vd141/Conductive-Fiber-Factory/Ink Parts/final Ink.SLDASM

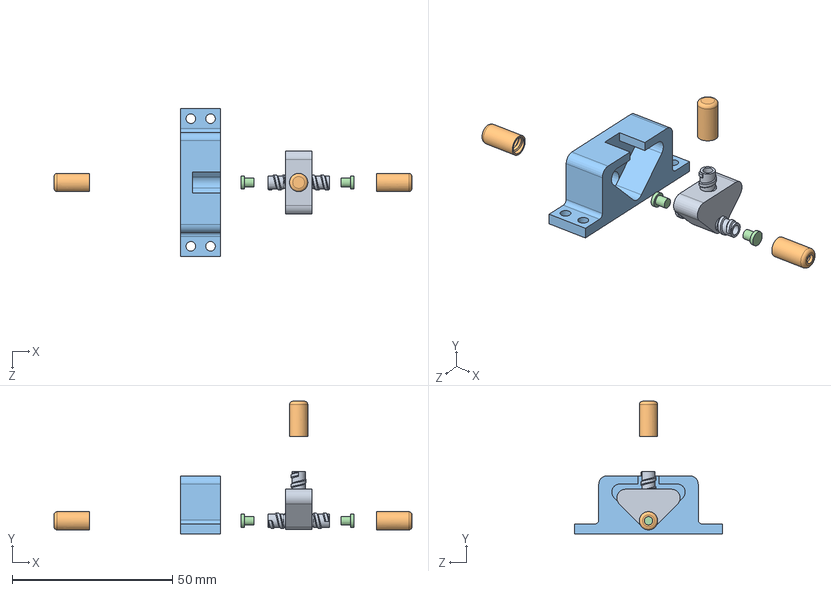
[picture p7: CAD file, 2020-08-11]
Ink Parts/final Ink.SLDASM
111.6 x 41.3 x 46.0 mm
finalCartridge
finalCap x 3
finalCartridgeHolder
PDMS Stopper x 2
