vd141/Conductive-Fiber-Factory/Ink Parts/inkAssembly.SLDASM

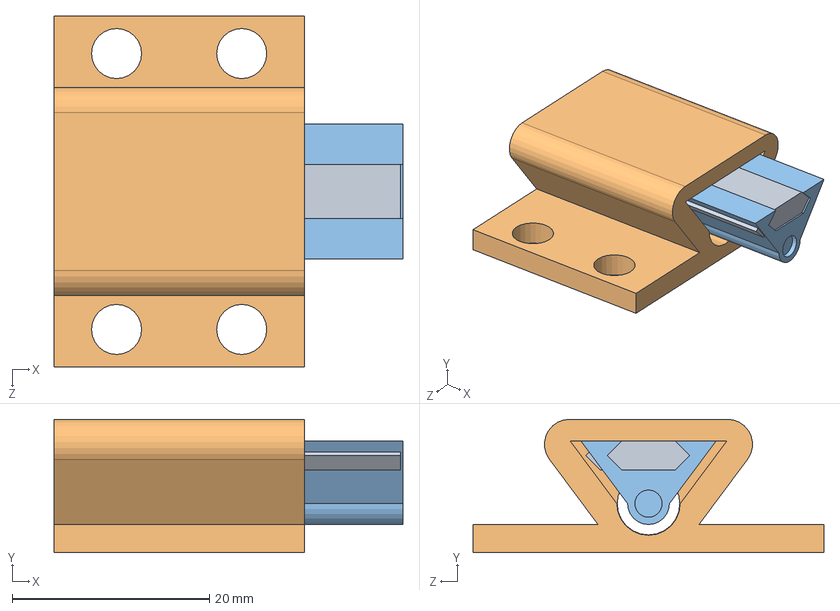
[picture p8: CAD file, 2020-08-11]
Ink Parts/inkAssembly.SLDASM
35.4 x 13.5 x 35.6 mm
newInkCartridgeLid
holdCartridge
newInkCartridge
