vd141/Conductive-Fiber-Factory/Ink Parts/homogenizer and ink.SLDASM

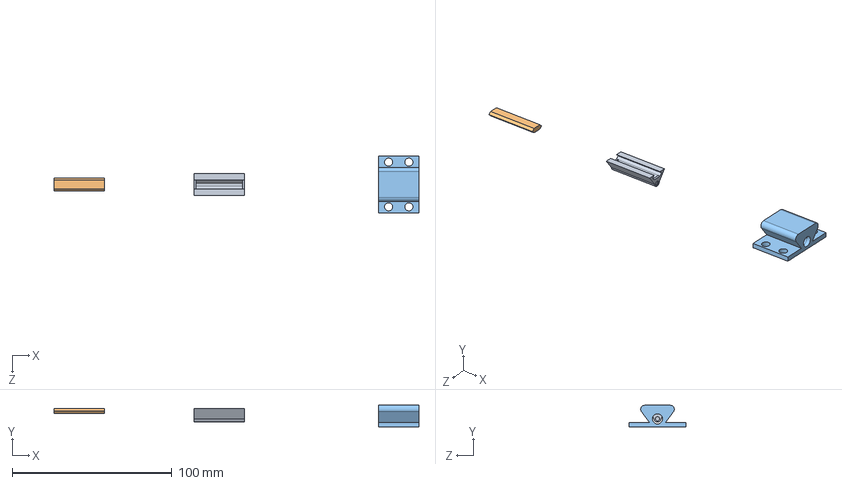
[picture p9: CAD file, 2020-08-11]
Ink Parts/homogenizer and ink.SLDASM
228.7 x 13.5 x 35.6 mm
newInkCartridge
newInkCartridgeLid
holdCartridge
