vd141/Conductive-Fiber-Factory/Ink Parts/homogenizerHolder.SLDPRT

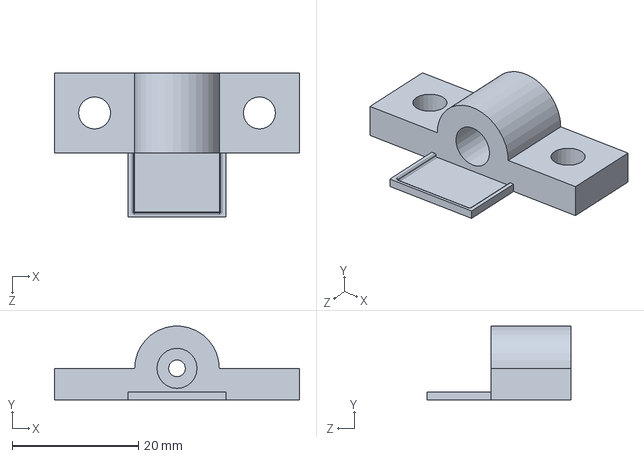
[picture p10: CAD file, 2020-08-11]
Ink Parts/homogenizerHolder.SLDPRT
38.8 x 11.7 x 22.9 mm
