vd141/Conductive-Fiber-Factory/Ink Parts/homogenizer.SLDPRT

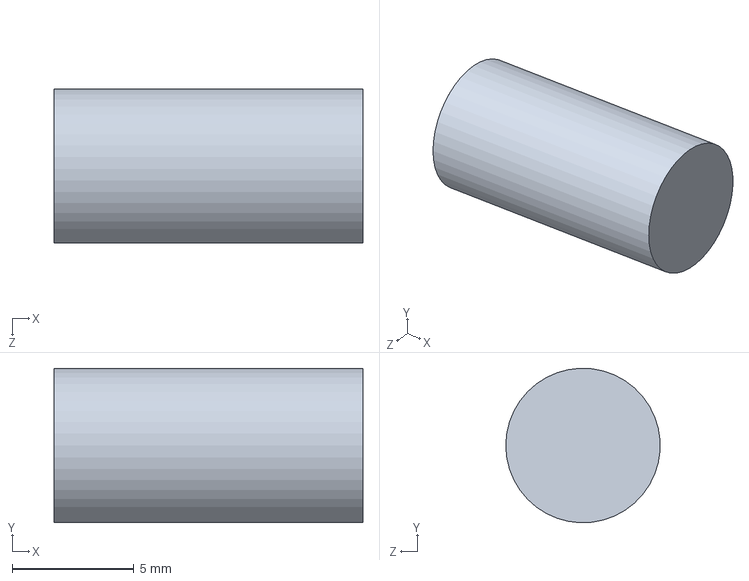
[picture p11: CAD file, 2020-08-11]
Ink Parts/homogenizer.SLDPRT
12.7 x 6.35 x 6.35 mm
