vd141/Conductive-Fiber-Factory/Ink Parts/threadHolder.SLDPRT

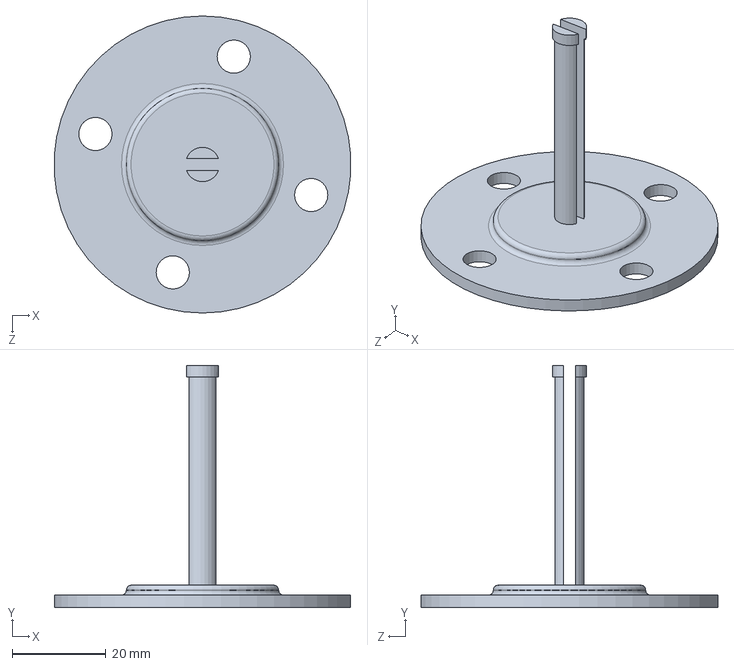
[picture p12: CAD file, 2020-08-11]
Ink Parts/threadHolder.SLDPRT
63.4 x 51.8 x 63.5 mm
