vd141/Conductive-Fiber-Factory/Ink Parts/finalCartridge.SLDPRT

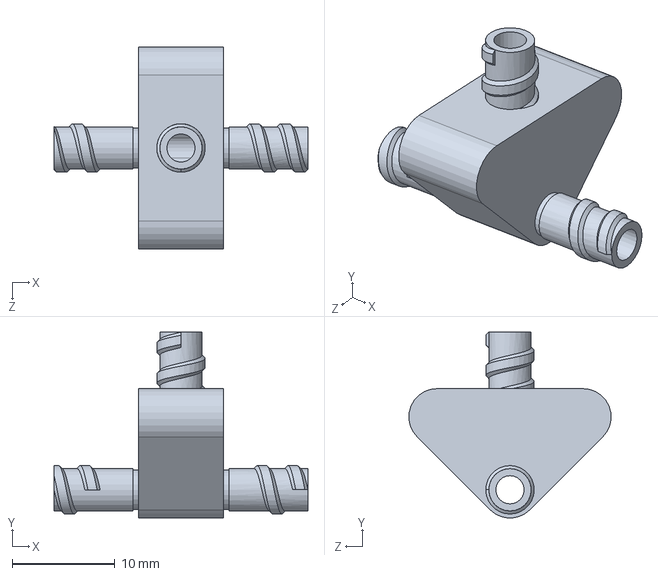
[picture p13: CAD file, 2020-08-11]
Ink Parts/finalCartridge.SLDPRT
24.8 x 18.1 x 19.7 mm
