vd141/Conductive-Fiber-Factory/Ink Parts/newInkCartridgeLid.SLDPRT

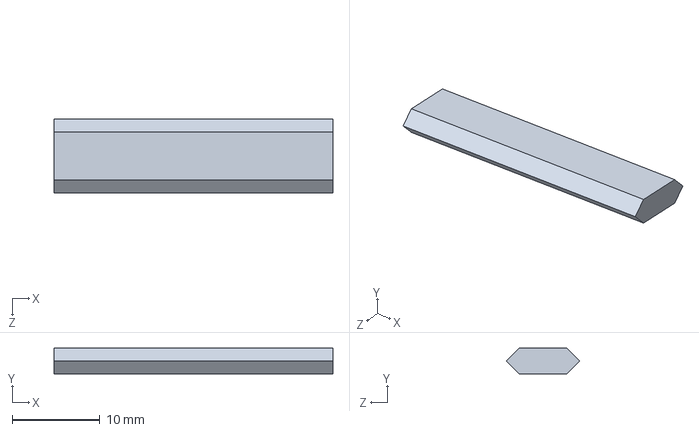
[picture p14: CAD file, 2020-08-11]
Ink Parts/newInkCartridgeLid.SLDPRT
31.8 x 2.94 x 8.37 mm
