vd141/Conductive-Fiber-Factory/Ink Parts/collectSpool.SLDPRT

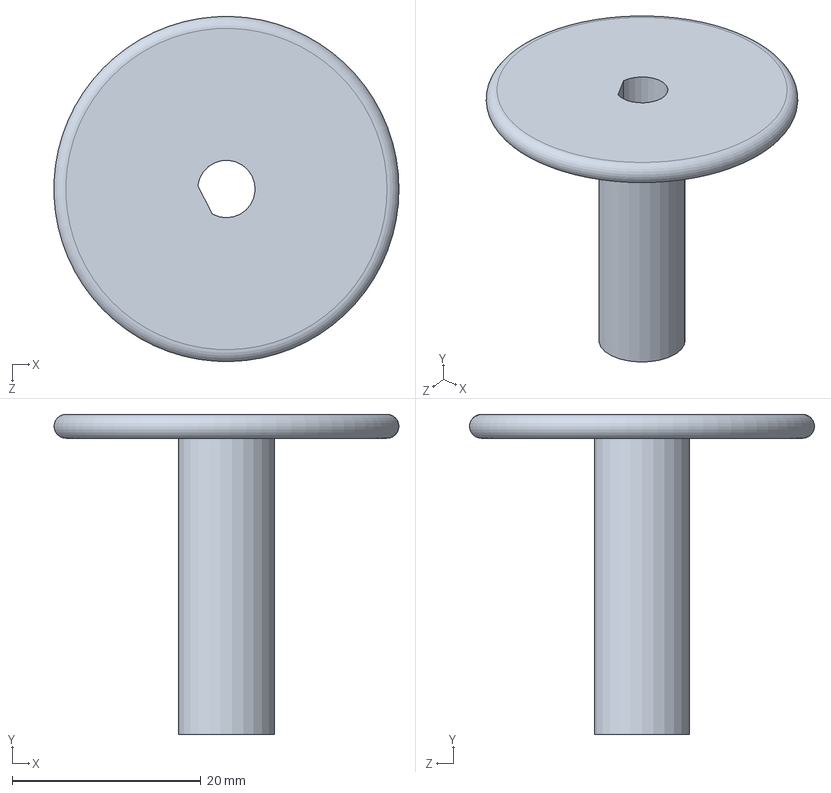
[picture p15: CAD file, 2020-08-11]
Ink Parts/collectSpool.SLDPRT
36.6 x 34.0 x 36.6 mm
