vd141/Conductive-Fiber-Factory/Ink Parts/collectSpoolHead.SLDPRT

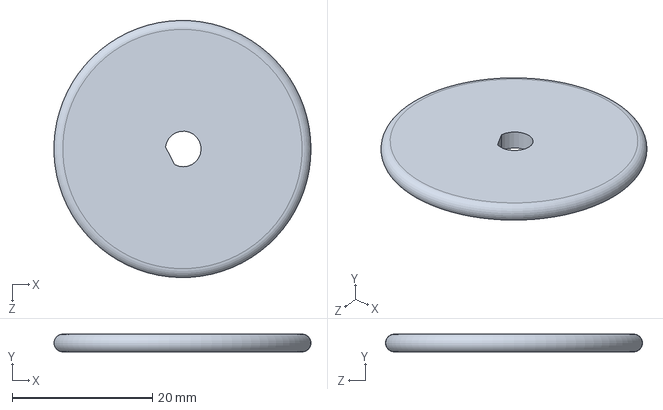
[picture p16: CAD file, 2020-08-11]
Ink Parts/collectSpoolHead.SLDPRT
36.6 x 2.54 x 36.6 mm
