vd141/Conductive-Fiber-Factory/Ink Parts/holdCartridge.SLDPRT

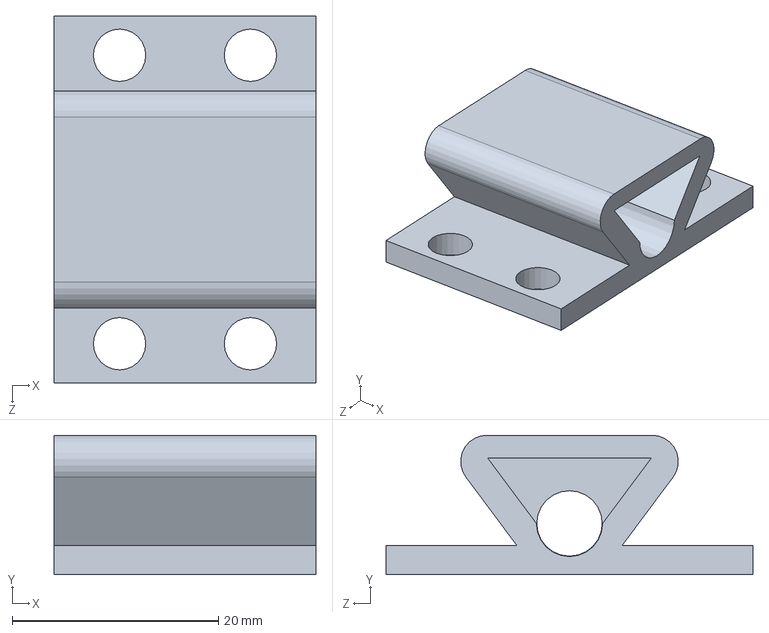
[picture p17: CAD file, 2020-08-11]
Ink Parts/holdCartridge.SLDPRT
25.4 x 13.5 x 35.6 mm
