vd141/Conductive-Fiber-Factory/Ink Parts/board.SLDPRT

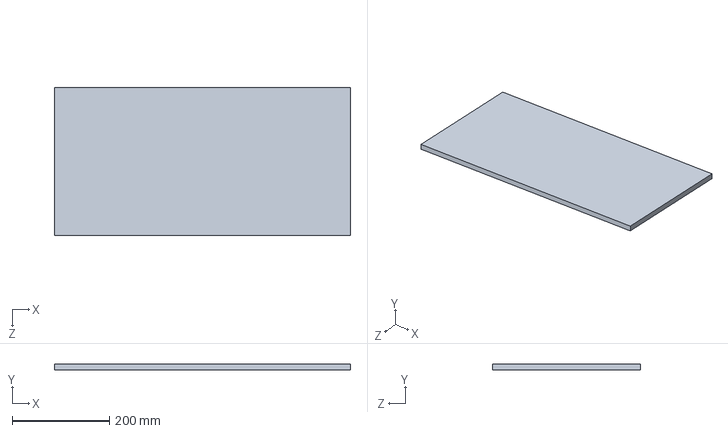
[picture p18: CAD file, 2020-08-11]
Ink Parts/board.SLDPRT
609.6 x 12.7 x 304.8 mm
