vd141/Conductive-Fiber-Factory/Ink Parts/finalCartridgeHolder.SLDPRT

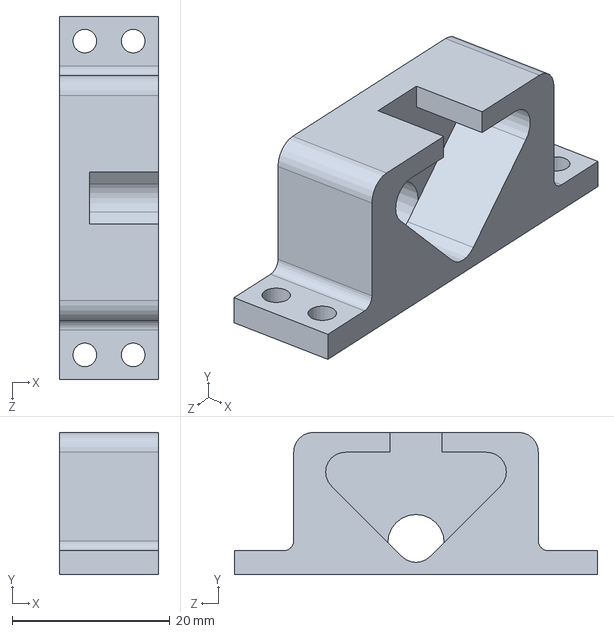
[picture p19: CAD file, 2020-08-11]
Ink Parts/finalCartridgeHolder.SLDPRT
12.5 x 18.0 x 46.0 mm
