vd141/Conductive-Fiber-Factory/Ink Parts/inkCartridge.SLDPRT

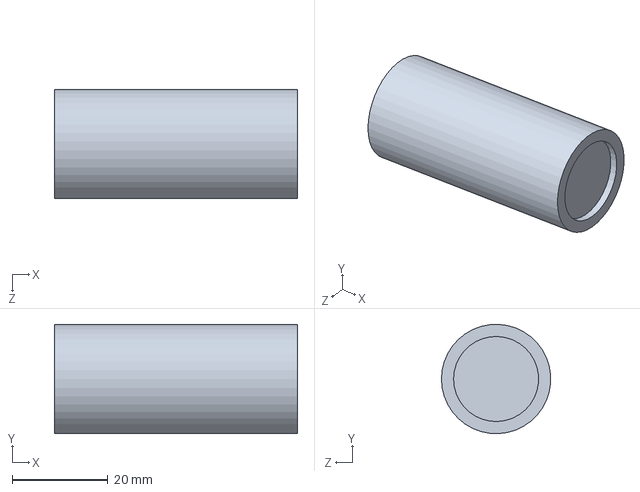
[picture p20: CAD file, 2020-08-11]
Ink Parts/inkCartridge.SLDPRT
50.8 x 22.8 x 22.8 mm
