vd141/Conductive-Fiber-Factory/Ink Parts/newInkCartridge.SLDPRT

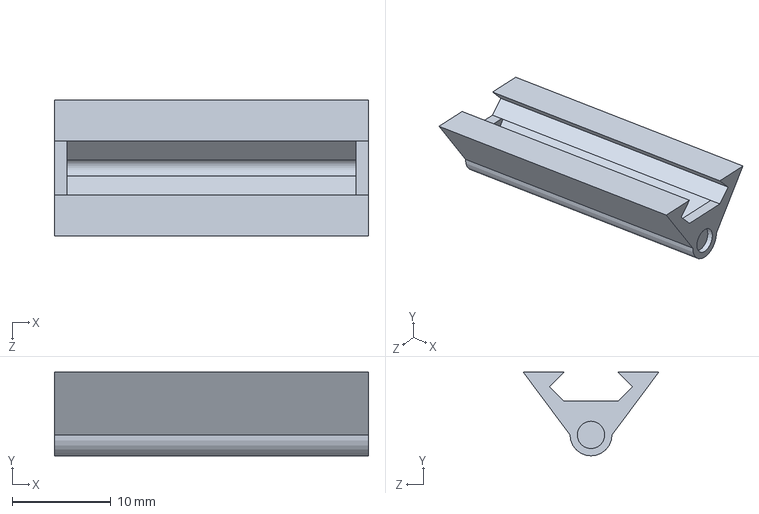
[picture p21: CAD file, 2020-08-11]
Ink Parts/newInkCartridge.SLDPRT
31.8 x 8.47 x 13.7 mm
