vd141/Conductive-Fiber-Factory/Ink Parts/finalCap.SLDPRT

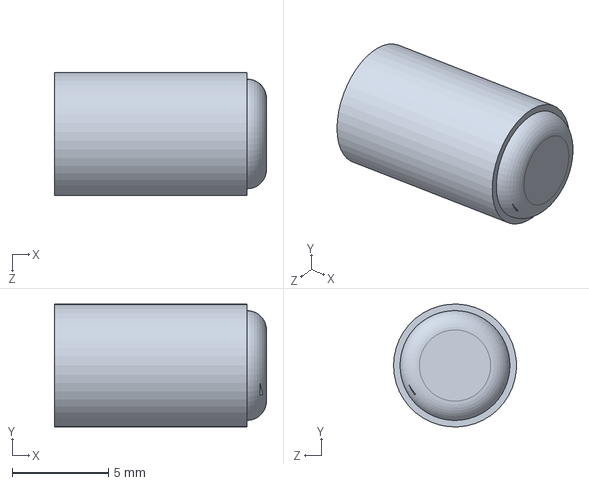
[picture p22: CAD file, 2020-08-11]
Ink Parts/finalCap.SLDPRT
11.0 x 6.37 x 6.38 mm
