vd141/Conductive-Fiber-Factory/Ink Parts/collectSpoolBase.SLDPRT

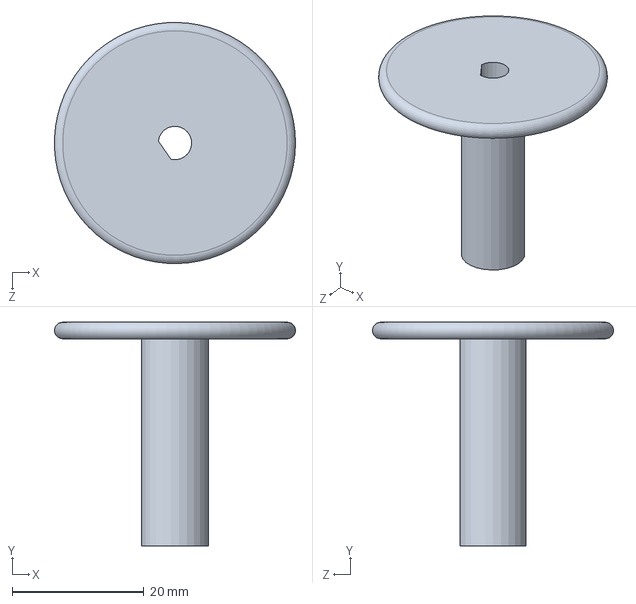
[picture p23: CAD file, 2020-08-11]
Ink Parts/collectSpoolBase.SLDPRT
36.6 x 34.0 x 36.6 mm
