vd141/Conductive-Fiber-Factory/Ink Parts/PDMS Stopper.SLDPRT

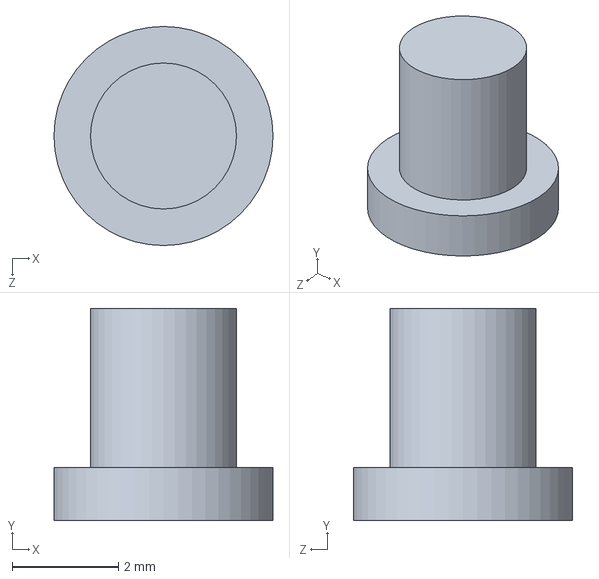
[picture p24: CAD file, 2020-08-11]
Ink Parts/PDMS Stopper.SLDPRT
4.12 x 4.00 x 4.12 mm
