vd141/Conductive-Fiber-Factory/(list of files, cad)

Other CAD files:
Ink Parts/screw caps.SLDPRT
