vd141/Conductive-Fiber-Factory/sheet metal cutout sketch for oven.PDF

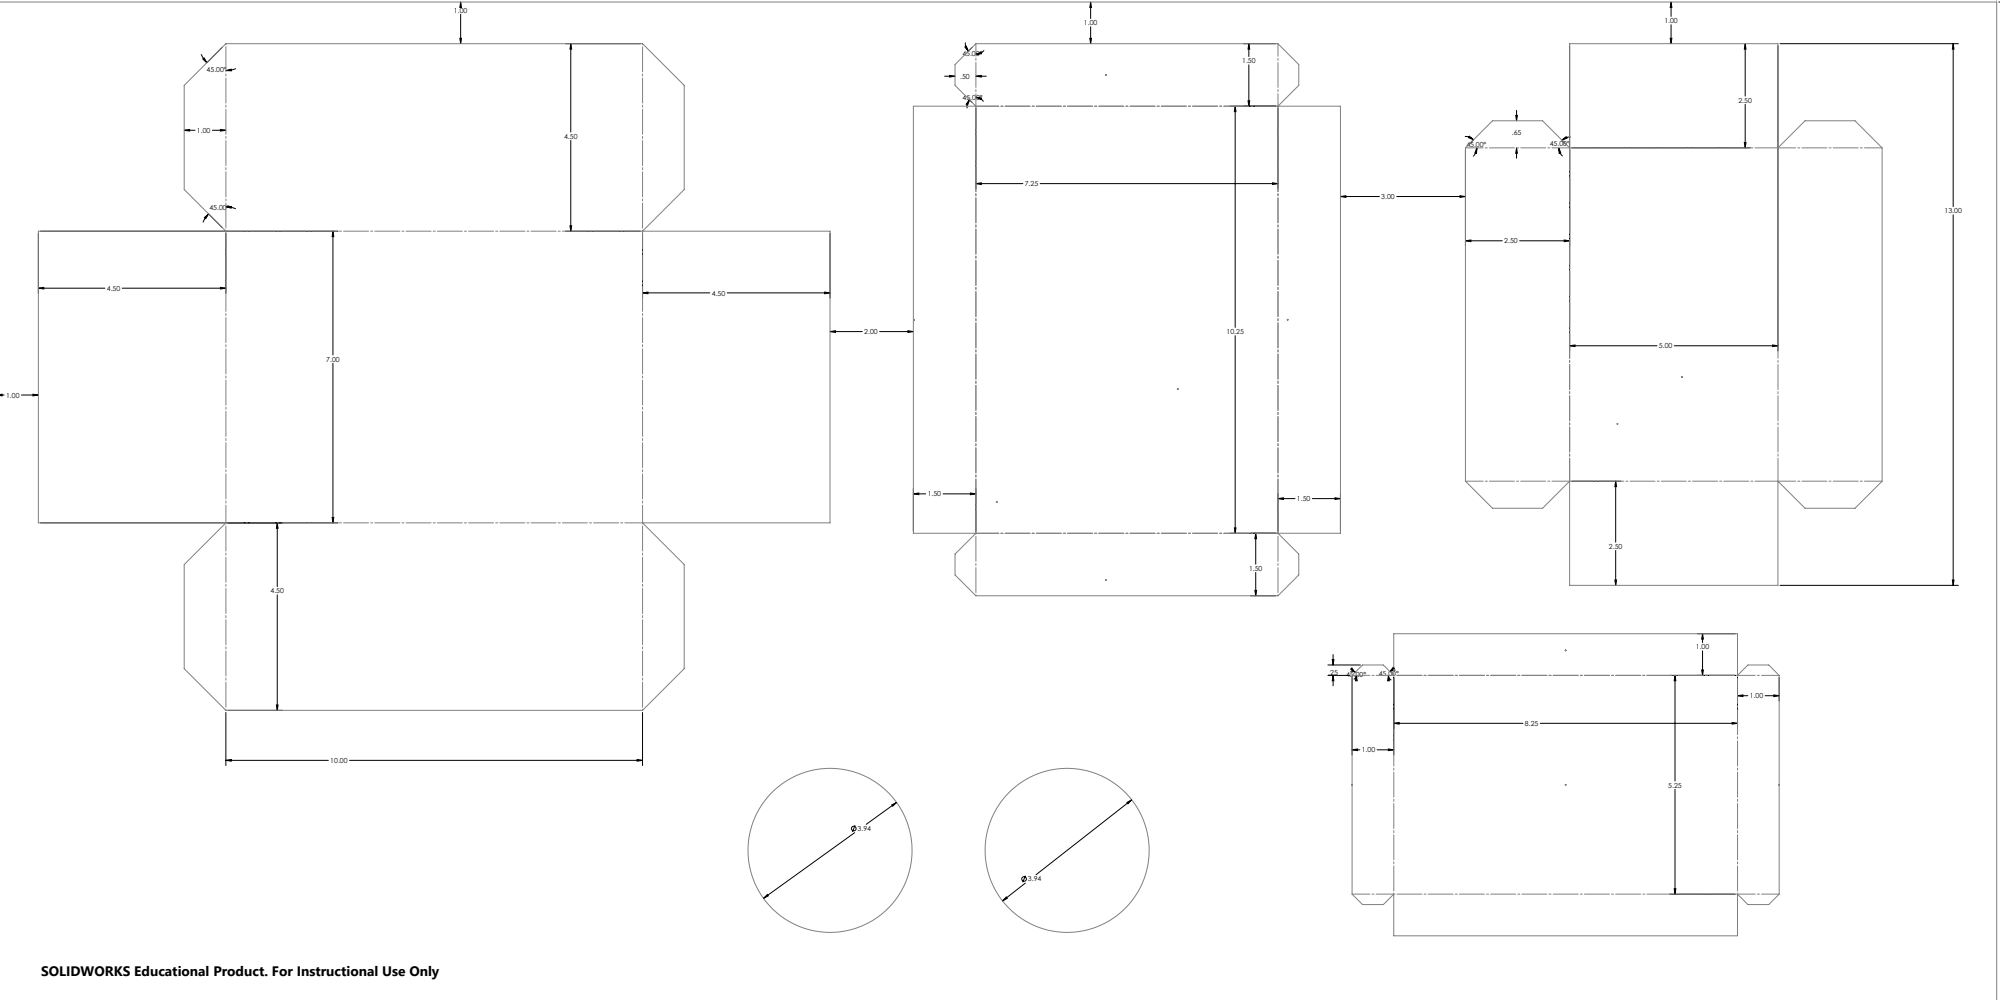
[picture p25: page 1]

SOLIDWORKS Educational Product. For Instructional Use Only
