vd141/Conductive-Fiber-Factory/Meeting Presentations/Progress and Future Steps - 1.pptx

## Smart Thread Machine

Victor Dinh

## The Idea

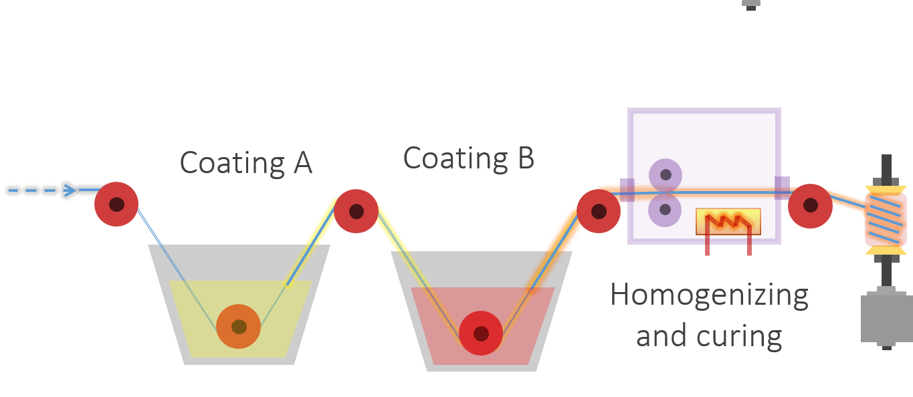
[picture p26: figure]

Photo creds: Hojat

## So Far…

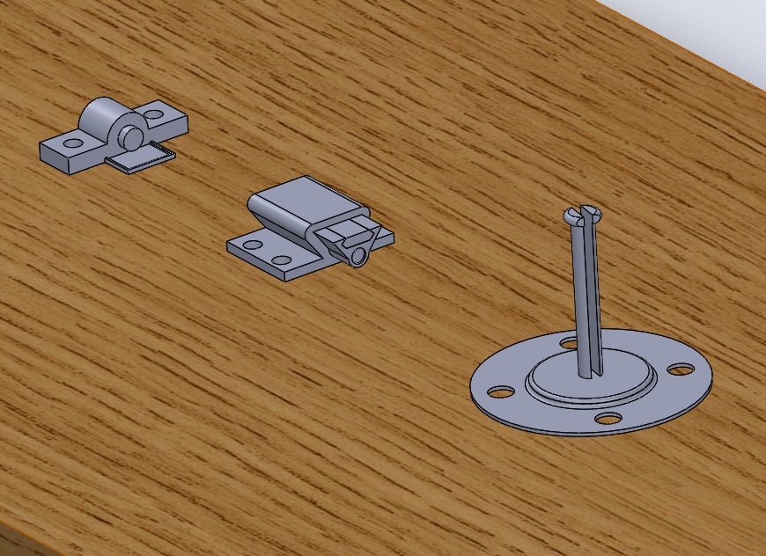
[picture p27: figure]

Homogenizer

Ink cartridge

Spool holder

## Components to build

- Build drying mechanism
- Build a winch to pull the thread through the machine

## Next Steps

- Order parts
- Learn how to program Arduino and/or Raspberry Pi
- Interface sensors with the microcontrollers
- Assemble all parts
- Test and improve machine
