vd141/Conductive-Fiber-Factory/Meeting Presentations/Progress and Future Steps - 2.pptx

## Smart Thread Machine

Victor Dinh

## The Basic Idea


Photo creds: Hojat

## So Far…


Homogenizer

Ink cartridge

Spool holder

## Machine components to build

- Build drying mechanism
- Build a winch to pull the thread through the machine

## Next Steps

- Finish setting up Raspberry Pi (display, peripherals)
- Learn how to program Raspberry Pi (Python)
- Interface sensors (temperature, humidity, camera sensors) with Raspberry Pi
- Assemble all parts of the machine
- Test and improve machine
- Make an app for the machine on Raspberry Pi?
