vd141/Conductive-Fiber-Factory/Meeting Presentations/Progress and Future Steps - 5.pptx

## Thread Factory

Almost there

## Heating works! (rudimentarily)

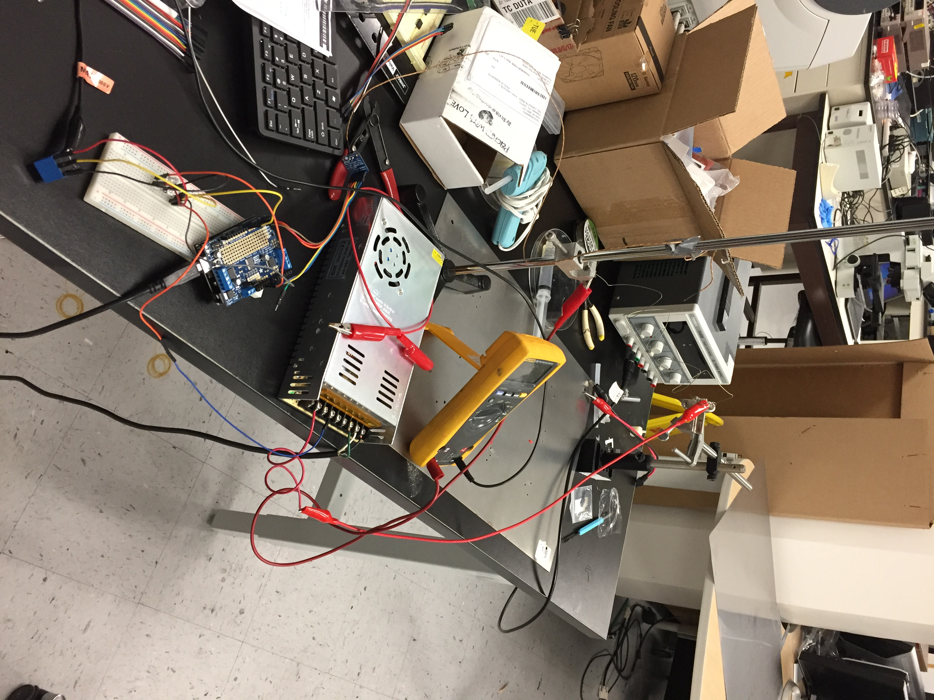
[picture p28: figure]

- Heavy duty wires
- PID Arduino code
- Cut and form enclosure (Tuesday)
- Install nichrome inside enclosure

Power supply

relay

## Ink Cartridge

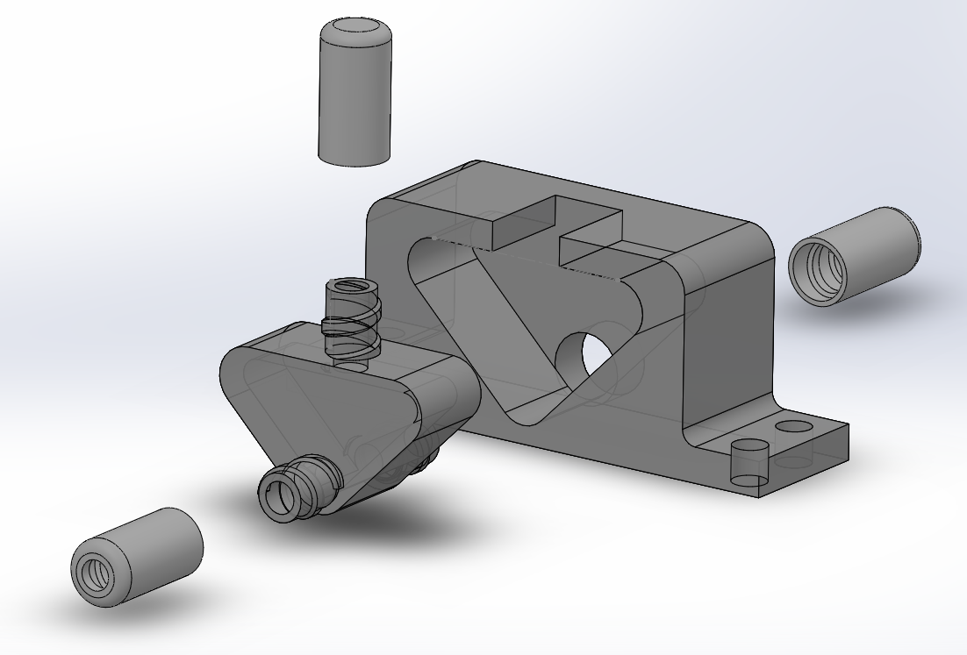
[picture p29: figure]
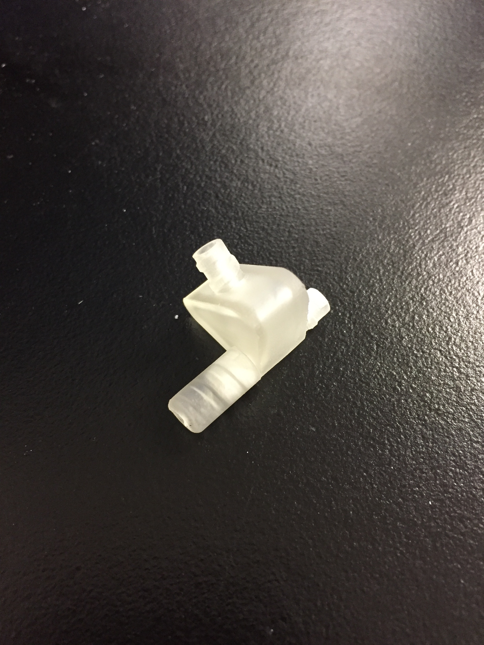
[picture p30: figure]
A picture containing indoor, wall, object Description generated with high confidence
